MOHXSSANN/volleyband/cad/renders/usb_opening_check.png

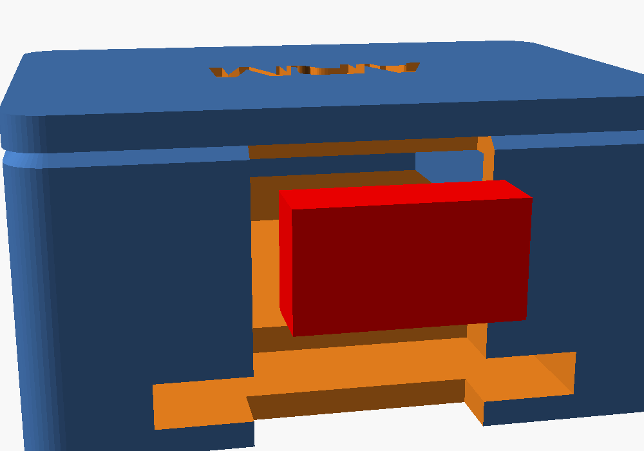
cad/renders/usb_opening_check.png
