MOHXSSANN/volleyband/photos/01-parts/board-and-battery.jpg

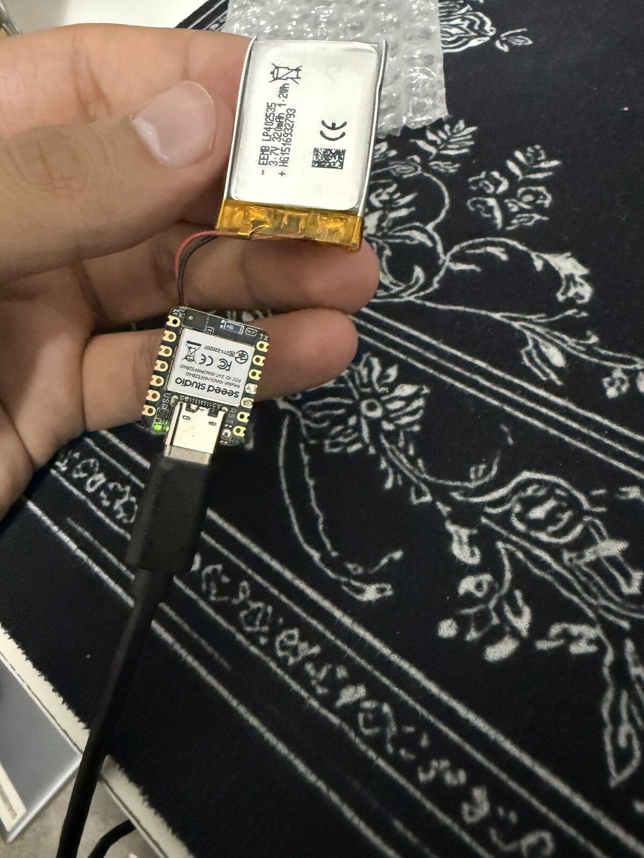
photos/01-parts/board-and-battery.jpg
