MOHXSSANN/volleyband/photos/01-parts/powered-on-blue-led.jpg

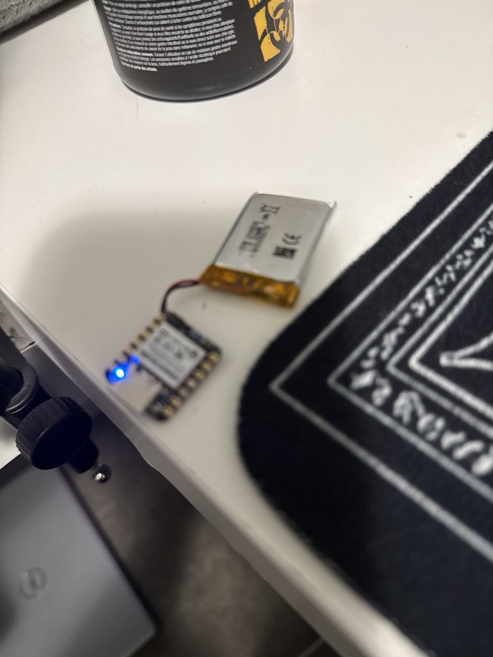
photos/01-parts/powered-on-blue-led.jpg
