MOHXSSANN/volleyband/cad/stl/pod_lid_ANKLE_v4.stl

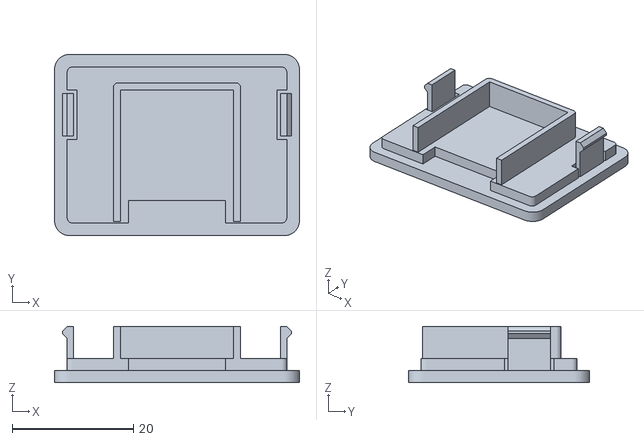
[picture p6: CAD file, 2026-11-03]
cad/stl/pod_lid_ANKLE_v4.stl
40.4 x 29.9 x 9.30
