MOHXSSANN/volleyband/cad/stl/pod_lid_ARM_v4.stl

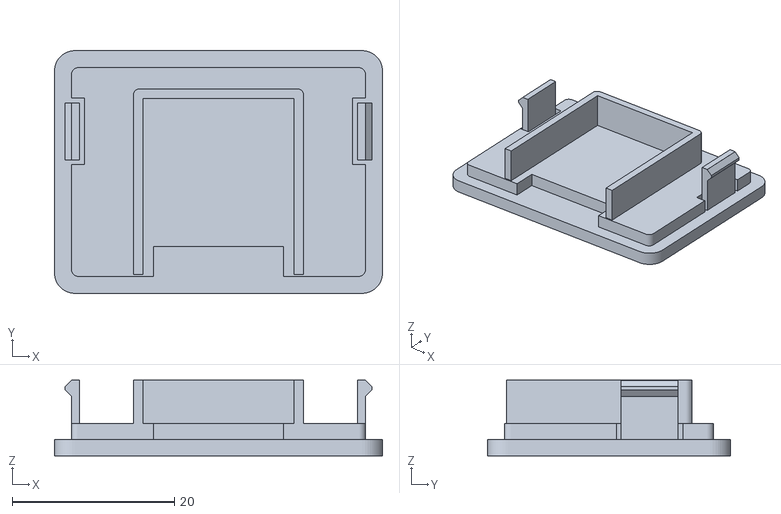
[picture p7: CAD file, 2026-11-03]
cad/stl/pod_lid_ARM_v4.stl
40.4 x 29.9 x 9.30
