MOHXSSANN/volleyband/cad/archive/v3/pod_lid_ARM_v3.stl

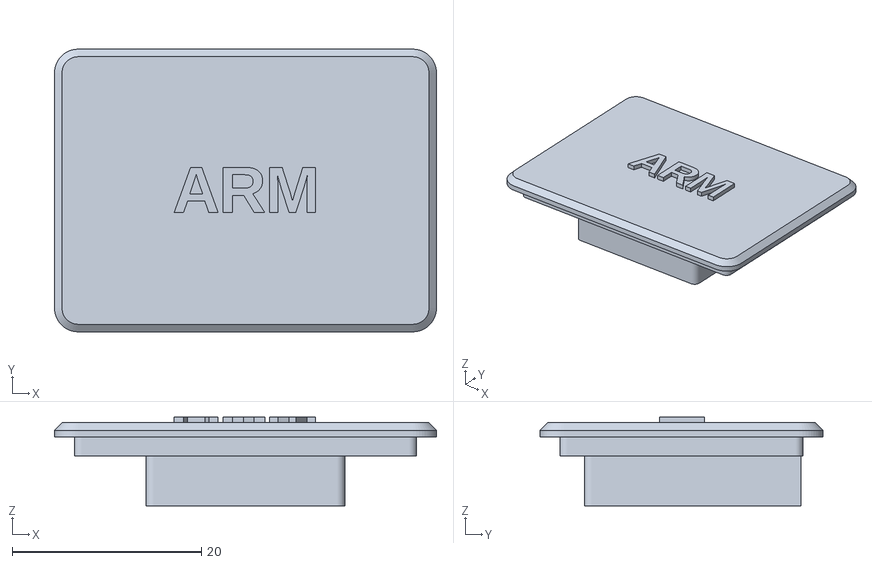
[picture p9: CAD file, 2026-11-03, an earlier design]
cad/archive/v3/pod_lid_ARM_v3.stl
40.4 x 29.9 x 9.40
