MOHXSSANN/volleyband/(list of files, cad)

Other CAD files:
cad/archive/v3/pod_case_v3.scad
