MOHXSSANN/volleyband/photos/01-parts/battery-soldered.jpg

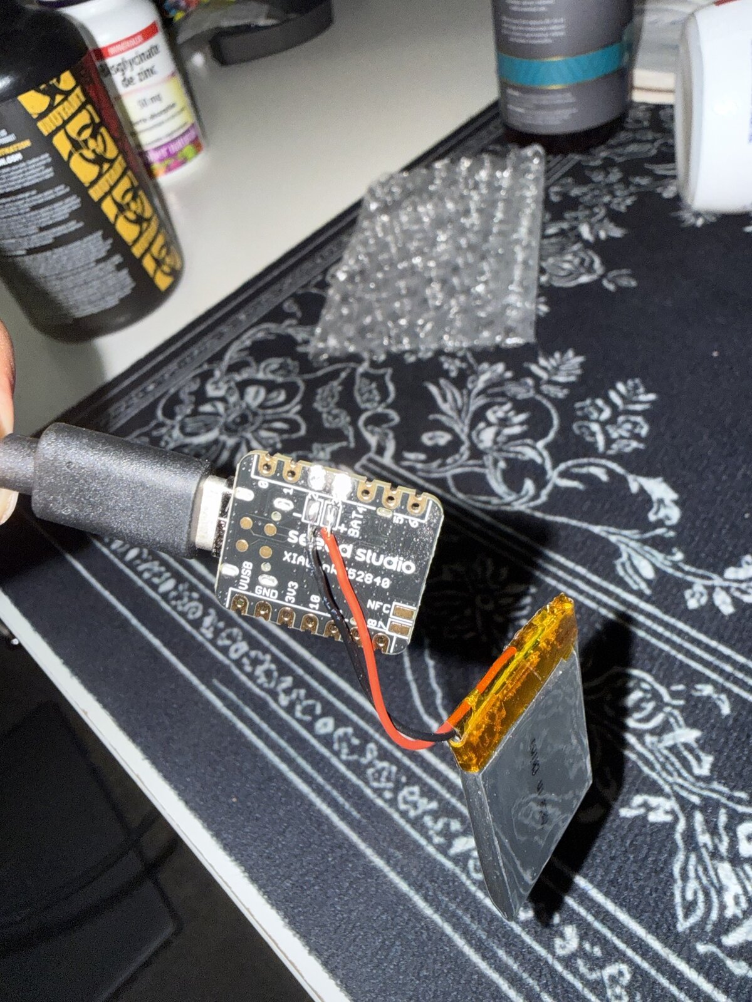
photos/01-parts/battery-soldered.jpg
