MOHXSSANN/volleyband/photos/02-wiring/first-solder-job.jpg

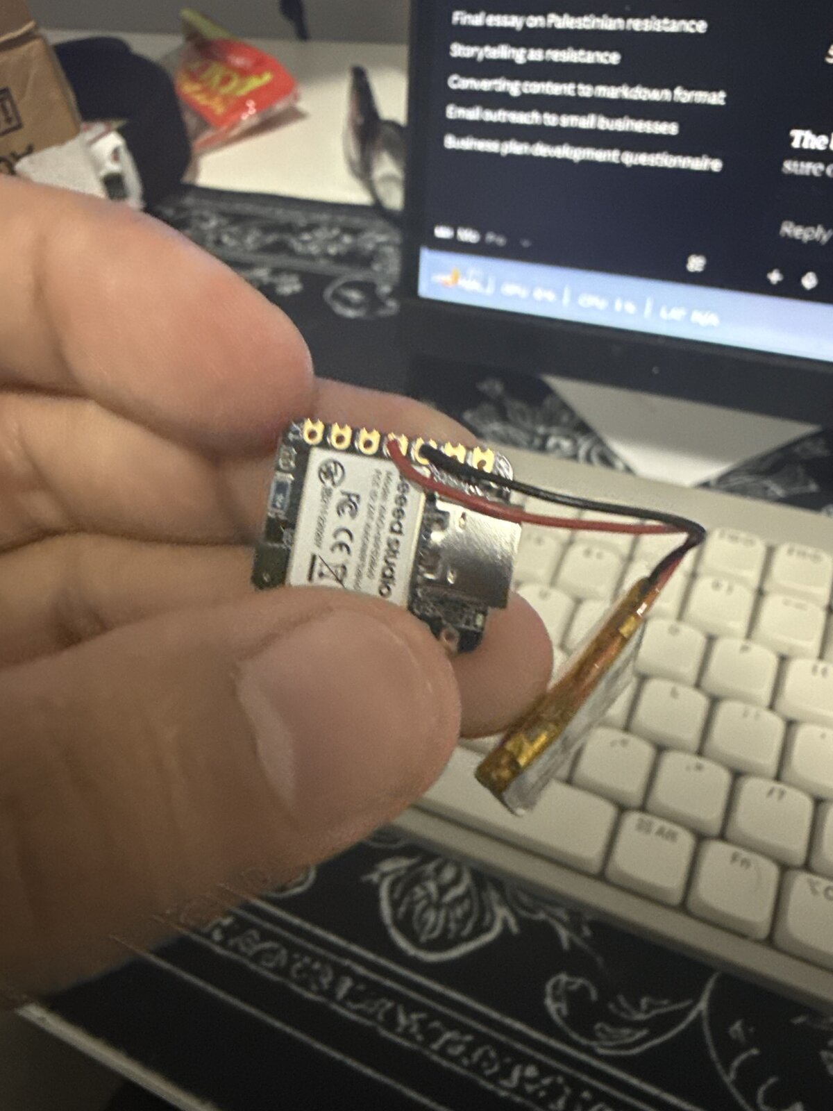
photos/02-wiring/first-solder-job.jpg
