MOHXSSANN/volleyband/photos/03-first-print-v3/case-front.jpg

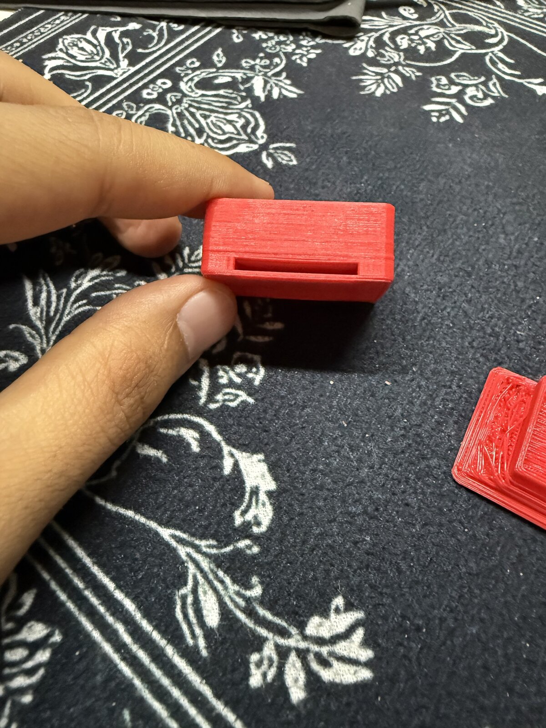
photos/03-first-print-v3/case-front.jpg
