MOHXSSANN/volleyband/photos/03-first-print-v3/case-open-top.jpg

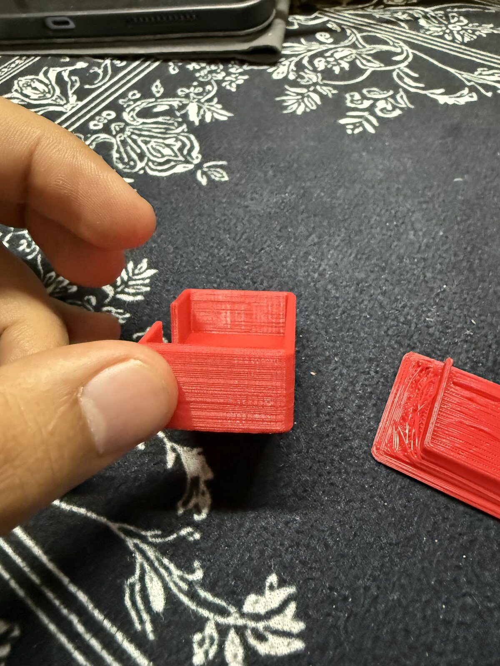
photos/03-first-print-v3/case-open-top.jpg
