MOHXSSANN/volleyband/photos/03-first-print-v3/case-side-groove.jpg

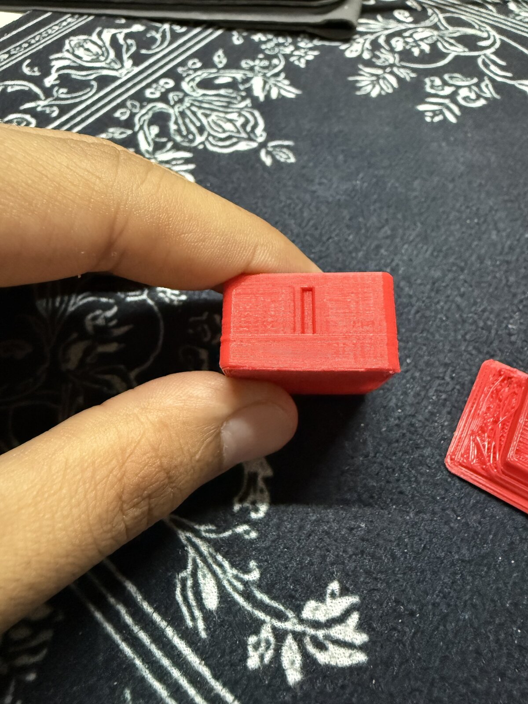
photos/03-first-print-v3/case-side-groove.jpg
