MOHXSSANN/volleyband/photos/03-first-print-v3/lid-inside-1.jpg

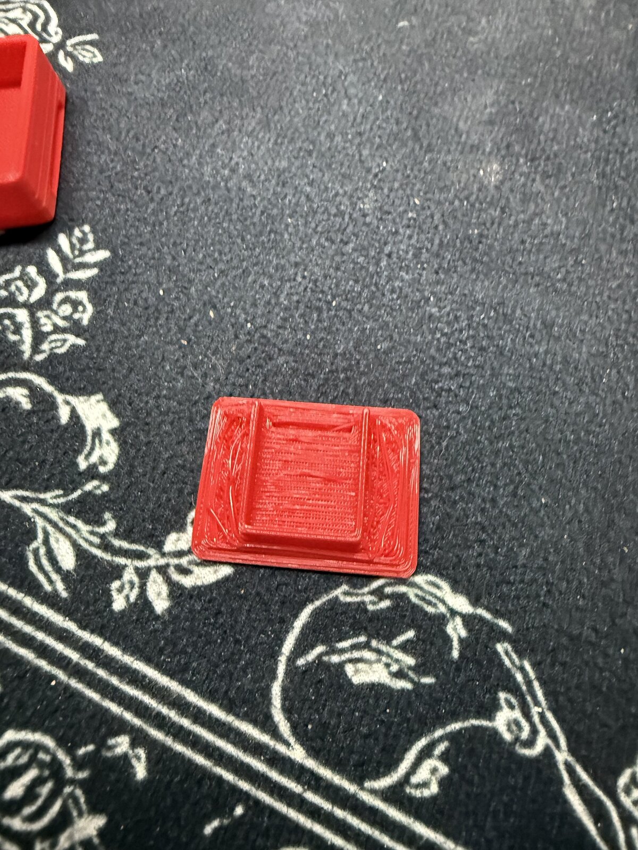
photos/03-first-print-v3/lid-inside-1.jpg
