MOHXSSANN/volleyband/photos/03-first-print-v3/lid-inside-2.jpg

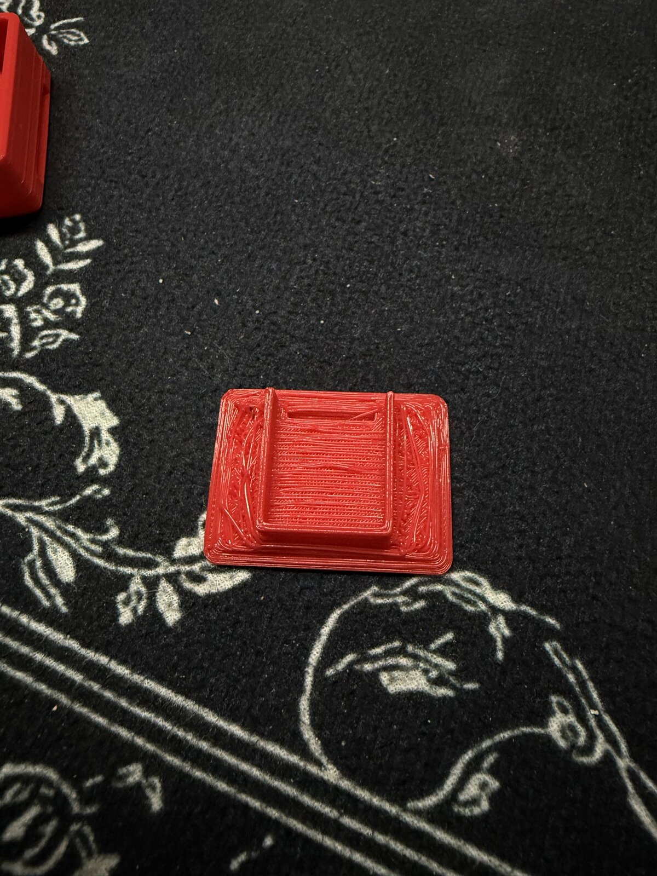
photos/03-first-print-v3/lid-inside-2.jpg
