MOHXSSANN/volleyband/photos/03-first-print-v3/lid-label-side.jpg

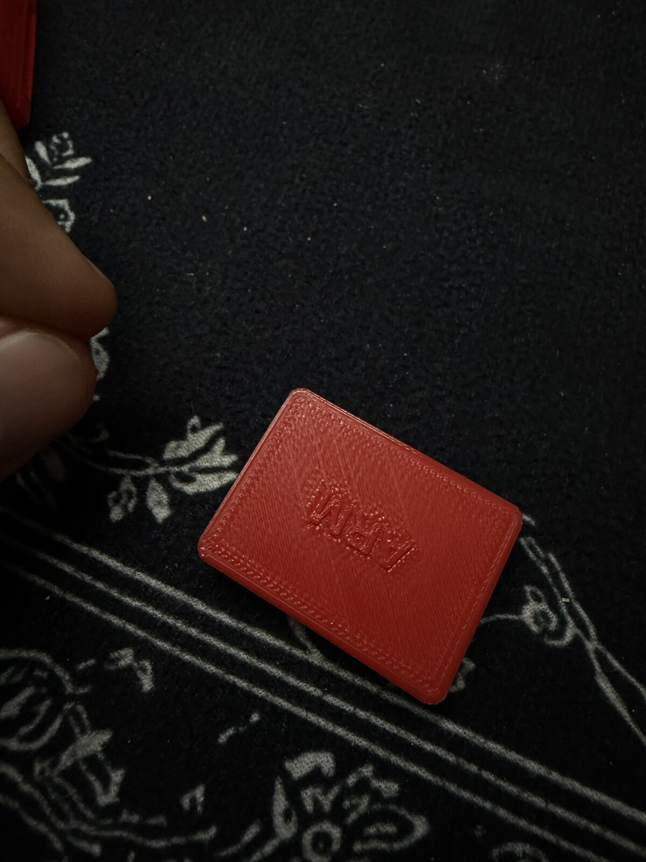
photos/03-first-print-v3/lid-label-side.jpg
