MOHXSSANN/volleyband/photos/03-first-print-v3/lid-ribs.jpg

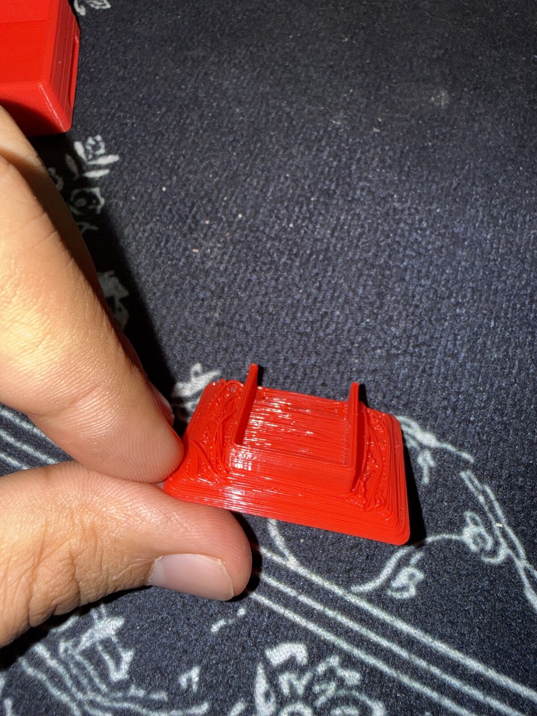
photos/03-first-print-v3/lid-ribs.jpg
