MOHXSSANN/volleyband/photos/03-first-print-v3/on-the-arm.jpg

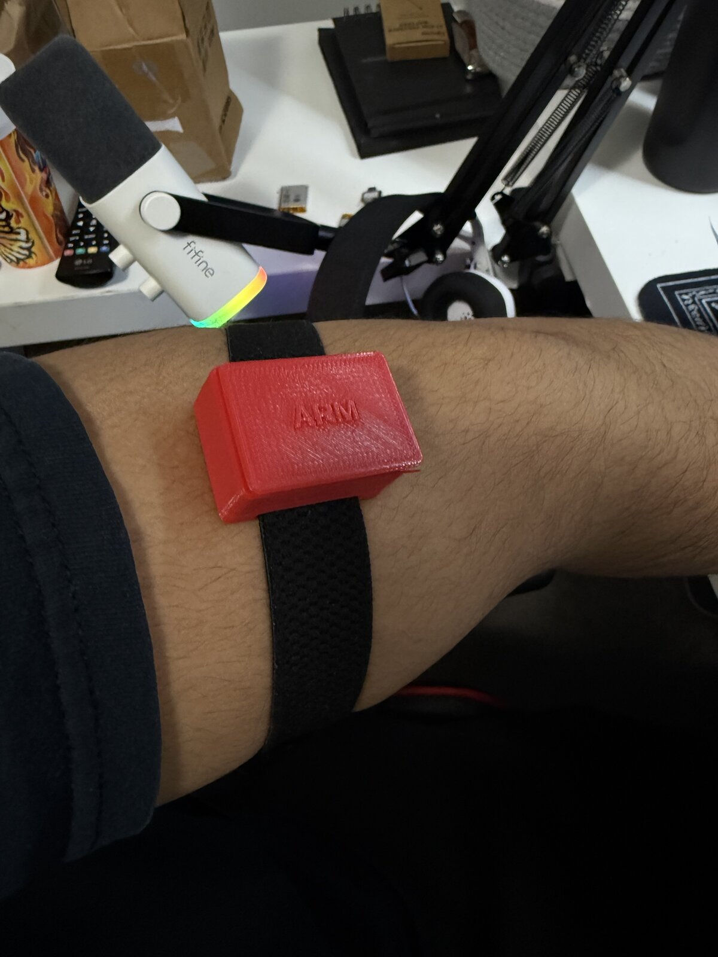
photos/03-first-print-v3/on-the-arm.jpg
