MOHXSSANN/volleyband/photos/03-first-print-v3/usb-notch-and-tunnel.jpg

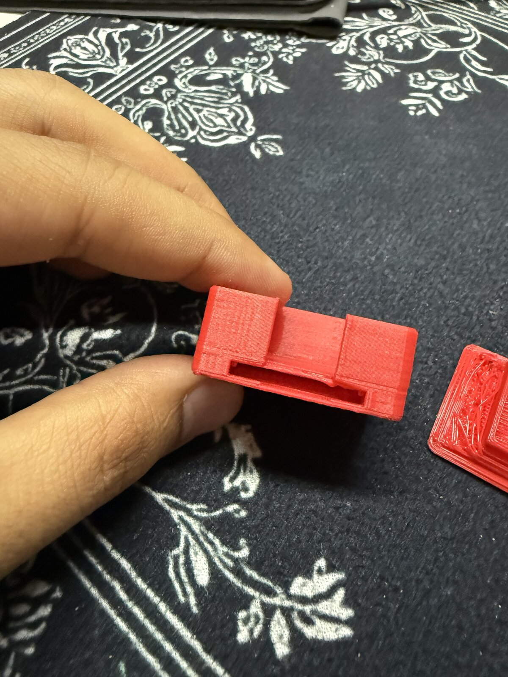
photos/03-first-print-v3/usb-notch-and-tunnel.jpg
