MOHXSSANN/volleyband/photos/03-first-print-v3/usb-notch-closeup.jpg

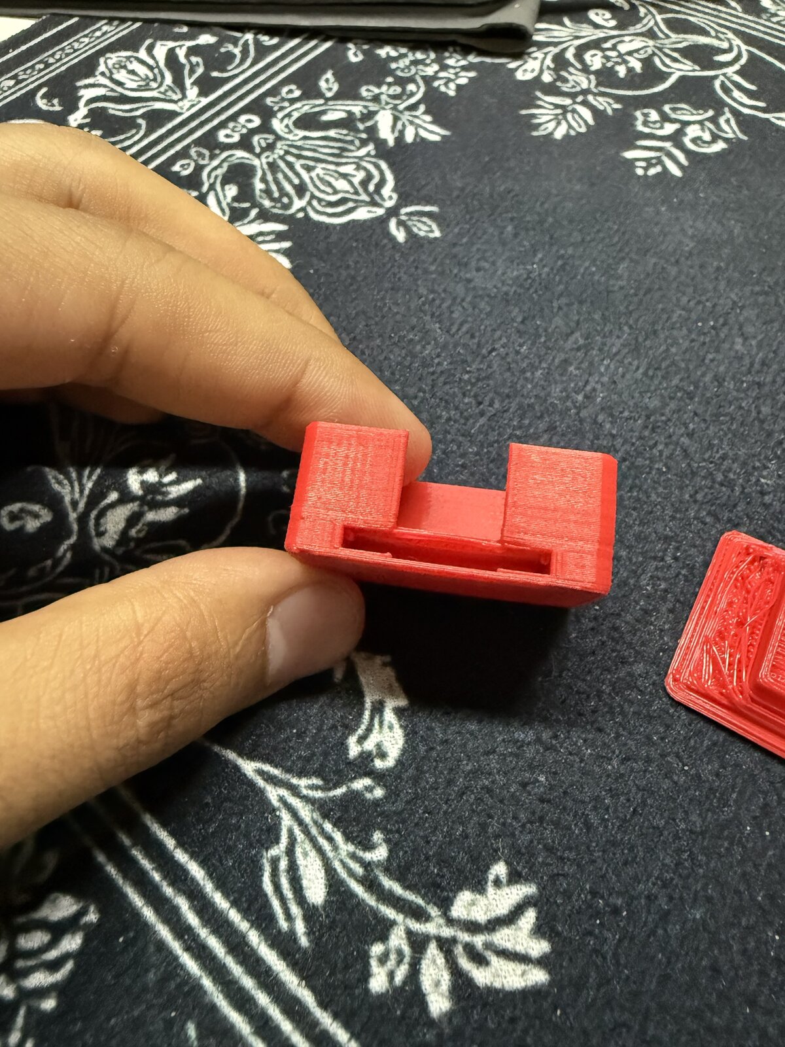
photos/03-first-print-v3/usb-notch-closeup.jpg
