MOHXSSANN/volleyband/photos/04-second-print-v4/pod-side.jpg

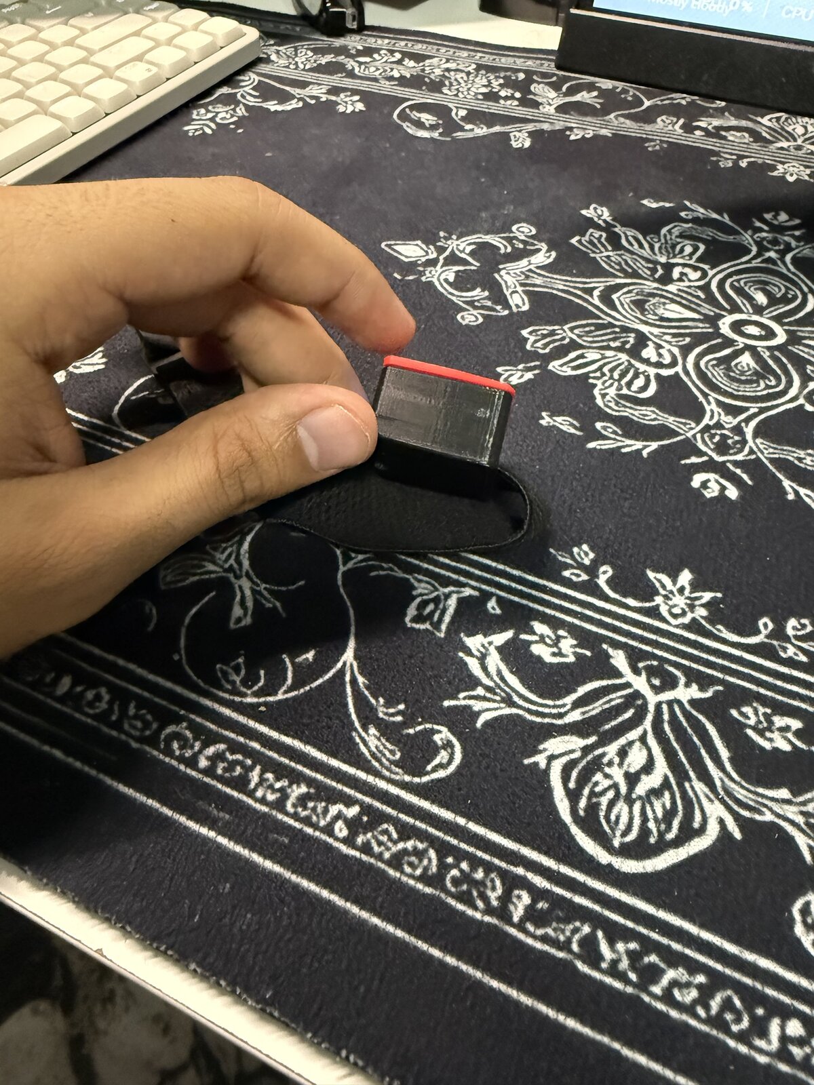
photos/04-second-print-v4/pod-side.jpg
