MOHXSSANN/volleyband/data/2026-11-02_bench_test/2026-11-02_18-48-11_VolleyBand-ANKLE.csv

pc_time | pod_ms | seq | ax_g | ay_g | az_g | gx_dps | gy_dps | gz_dps | acc_mag_g | gyro_mag_dps
1793663293.494 | 131966 | 121 | 0.637 | 0.529 | 0.585 | 0.4 | -1.3 | 0.3 | 1.014 | 1.4
1793663293.494 | 131976 | 122 | 0.635 | 0.532 | 0.583 | 0.3 | -1.3 | 0.4 | 1.013 | 1.4
1793663293.505 | 131987 | 123 | 0.636 | 0.529 | 0.585 | 0.3 | -1.4 | 0.4 | 1.013 | 1.5
1793663293.527 | 131996 | 124 | 0.639 | 0.528 | 0.586 | 0.3 | -1.4 | 0.3 | 1.015 | 1.5
1793663293.528 | 132006 | 125 | 0.638 | 0.530 | 0.585 | 0.4 | -1.4 | 0.3 | 1.015 | 1.5
1793663293.539 | 132016 | 126 | 0.637 | 0.530 | 0.581 | 0.4 | -1.4 | 0.4 | 1.012 | 1.5
1793663293.539 | 132026 | 127 | 0.638 | 0.530 | 0.584 | 0.2 | -1.4 | 0.4 | 1.014 | 1.5
1793663293.550 | 132036 | 128 | 0.640 | 0.528 | 0.585 | 0.2 | -1.4 | 0.3 | 1.015 | 1.4
1793663293.561 | 132051 | 129 | 0.638 | 0.530 | 0.585 | 0.3 | -1.3 | 0.4 | 1.015 | 1.4
1793663293.572 | 132057 | 130 | 0.638 | 0.531 | 0.582 | 0.2 | -1.5 | 0.4 | 1.014 | 1.6
1793663293.595 | 132066 | 131 | 0.636 | 0.528 | 0.584 | 0.1 | -1.5 | 0.4 | 1.012 | 1.5
1793663293.595 | 132077 | 132 | 0.637 | 0.529 | 0.585 | 0.2 | -1.4 | 0.4 | 1.014 | 1.5
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
