MOHXSSANN/volleyband/data/2026-11-02_bench_test/2026-11-02_18-48-11_VolleyBand-ARM.csv

pc_time | pod_ms | seq | ax_g | ay_g | az_g | gx_dps | gy_dps | gz_dps | acc_mag_g | gyro_mag_dps
1793663294.980 | 286683 | 110 | 0.138 | -0.001 | 1.063 | 0.4 | -2.0 | -0.4 | 1.072 | 2.0
1793663294.981 | 286693 | 111 | 0.136 | -0.002 | 1.061 | 0.3 | -2.0 | -0.3 | 1.070 | 2.0
1793663294.991 | 286699 | 112 | 0.137 | -0.002 | 1.063 | 0.2 | -2.1 | -0.4 | 1.072 | 2.1
1793663295.002 | 286708 | 113 | 0.137 | -0.002 | 1.063 | 0.2 | -2.0 | -0.4 | 1.072 | 2.1
1793663295.013 | 286720 | 114 | 0.136 | -0.002 | 1.062 | 0.4 | -2.0 | -0.4 | 1.071 | 2.0
1793663295.024 | 286728 | 115 | 0.138 | -0.002 | 1.063 | 0.4 | -2.0 | -0.4 | 1.072 | 2.1
1793663295.025 | 286739 | 116 | 0.137 | -0.002 | 1.063 | 0.3 | -1.9 | -0.4 | 1.072 | 2.0
1793663295.047 | 286748 | 117 | 0.136 | -0.002 | 1.063 | 0.2 | -2.2 | -0.3 | 1.072 | 2.2
1793663295.058 | 286758 | 118 | 0.137 | -0.000 | 1.064 | 0.3 | -2.1 | -0.3 | 1.073 | 2.1
1793663295.059 | 286769 | 119 | 0.137 | -0.001 | 1.064 | 0.4 | -2.0 | -0.3 | 1.073 | 2.0
1793663295.069 | 286778 | 120 | 0.137 | 0.000 | 1.062 | 0.4 | -2.0 | -0.4 | 1.071 | 2.1
1793663295.081 | 286791 | 121 | 0.136 | -0.003 | 1.063 | 0.3 | -2.1 | -0.4 | 1.072 | 2.1
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
