MOHXSSANN/volleyband/data/2026-11-02_bench_test/2026-11-02_18-50-34_VolleyBand-ANKLE.csv

pc_time | pod_ms | seq | ax_g | ay_g | az_g | gx_dps | gy_dps | gz_dps | acc_mag_g | gyro_mag_dps
1793663435.194 | 273670 | 68 | 0.680 | 0.486 | 0.576 | 0.4 | -1.3 | 0.2 | 1.015 | 1.4
1793663435.195 | 273681 | 69 | 0.681 | 0.484 | 0.571 | 0.5 | -1.3 | 0.1 | 1.012 | 1.4
1793663435.208 | 273690 | 70 | 0.678 | 0.484 | 0.573 | 0.4 | -1.3 | 0.3 | 1.011 | 1.4
1793663435.222 | 273701 | 71 | 0.681 | 0.483 | 0.574 | 0.4 | -1.3 | 0.5 | 1.013 | 1.4
1793663435.235 | 273710 | 72 | 0.682 | 0.487 | 0.572 | 0.4 | -1.4 | 0.6 | 1.014 | 1.5
1793663435.236 | 273720 | 73 | 0.679 | 0.484 | 0.571 | 0.4 | -1.3 | 0.4 | 1.011 | 1.4
1793663435.249 | 273730 | 74 | 0.678 | 0.482 | 0.572 | 0.5 | -1.3 | 0.4 | 1.009 | 1.4
1793663435.262 | 273740 | 75 | 0.678 | 0.484 | 0.574 | 0.4 | -1.2 | 0.4 | 1.012 | 1.3
1793663435.276 | 273750 | 76 | 0.679 | 0.484 | 0.574 | 0.3 | -1.3 | 0.4 | 1.012 | 1.4
1793663435.277 | 273760 | 77 | 0.679 | 0.481 | 0.572 | 0.3 | -1.3 | 0.4 | 1.010 | 1.4
1793663435.290 | 273770 | 78 | 0.680 | 0.481 | 0.572 | 0.3 | -1.3 | 0.4 | 1.010 | 1.4
1793663435.304 | 273780 | 79 | 0.679 | 0.484 | 0.572 | 0.4 | -1.3 | 0.4 | 1.011 | 1.4
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
