MOHXSSANN/volleyband/data/2026-11-02_bench_test/2026-11-02_19-05-55_VolleyBand-ANKLE.csv

pc_time | pod_ms | seq | ax_g | ay_g | az_g | gx_dps | gy_dps | gz_dps | acc_mag_g | gyro_mag_dps
1793664356.827 | 609915 | 66 | 0.899 | 0.277 | 0.344 | 0.5 | -1.3 | 0.4 | 1.002 | 1.5
1793664356.841 | 609925 | 67 | 0.897 | 0.279 | 0.342 | 0.4 | -1.3 | 0.4 | 1.000 | 1.4
1793664356.965 | 609935 | 68 | 0.898 | 0.278 | 0.342 | 0.4 | -1.3 | 0.4 | 1.001 | 1.4
1793664356.965 | 609947 | 69 | 0.897 | 0.278 | 0.340 | 0.4 | -1.3 | 0.4 | 0.999 | 1.4
1793664356.965 | 609957 | 70 | 0.899 | 0.280 | 0.341 | 0.4 | -1.3 | 0.4 | 1.002 | 1.4
1793664356.965 | 609965 | 71 | 0.899 | 0.278 | 0.341 | 0.4 | -1.3 | 0.4 | 1.001 | 1.4
1793664356.965 | 609977 | 72 | 0.901 | 0.277 | 0.343 | 0.5 | -1.3 | 0.4 | 1.003 | 1.5
1793664356.965 | 609987 | 73 | 0.897 | 0.278 | 0.341 | 0.4 | -1.3 | 0.5 | 0.999 | 1.4
1793664356.965 | 609997 | 74 | 0.900 | 0.280 | 0.339 | 0.4 | -1.3 | 0.4 | 1.001 | 1.4
1793664356.965 | 610005 | 75 | 0.899 | 0.277 | 0.344 | 0.4 | -1.3 | 0.4 | 1.002 | 1.4
1793664357.048 | 610015 | 76 | 0.899 | 0.280 | 0.344 | 0.4 | -1.4 | 0.4 | 1.003 | 1.5
1793664357.048 | 610025 | 77 | 0.899 | 0.279 | 0.343 | 0.4 | -1.3 | 0.5 | 1.002 | 1.4
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
