MOHXSSANN/volleyband/data/2026-11-02_bench_test/2026-11-02_19-05-55_VolleyBand-ARM.csv

pc_time | pod_ms | seq | ax_g | ay_g | az_g | gx_dps | gy_dps | gz_dps | acc_mag_g | gyro_mag_dps
1793664357.090 | 387941 | 66 | -0.741 | 0.689 | 0.128 | 0.7 | -1.7 | 0.3 | 1.020 | 1.8
1793664357.104 | 387951 | 67 | -0.742 | 0.692 | 0.127 | 0.8 | -1.8 | 0.2 | 1.023 | 1.9
1793664357.117 | 387961 | 68 | -0.737 | 0.696 | 0.125 | 1.1 | -1.8 | 0.1 | 1.022 | 2.0
1793664357.202 | 387971 | 69 | -0.738 | 0.701 | 0.124 | 0.8 | -1.8 | -0.1 | 1.025 | 1.9
1793664357.202 | 387984 | 70 | -0.736 | 0.699 | 0.123 | 0.7 | -2.0 | -0.3 | 1.022 | 2.2
1793664357.202 | 387994 | 71 | -0.737 | 0.697 | 0.122 | 0.8 | -2.0 | -0.6 | 1.022 | 2.2
1793664357.202 | 388004 | 72 | -0.738 | 0.702 | 0.121 | 0.8 | -1.8 | -0.8 | 1.025 | 2.1
1793664357.202 | 388013 | 73 | -0.742 | 0.702 | 0.122 | 0.7 | -2.2 | -1.0 | 1.029 | 2.5
1793664357.202 | 388021 | 74 | -0.739 | 0.697 | 0.122 | 0.5 | -2.8 | -1.2 | 1.024 | 3.1
1793664357.202 | 388031 | 75 | -0.740 | 0.697 | 0.122 | 0.6 | -3.2 | -1.1 | 1.024 | 3.4
1793664357.202 | 388041 | 76 | -0.739 | 0.696 | 0.122 | 0.6 | -3.1 | -1.3 | 1.022 | 3.4
1793664357.285 | 388051 | 77 | -0.738 | 0.698 | 0.125 | 0.5 | -3.0 | -1.3 | 1.023 | 3.3
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
